pjlobo/SD_Card_Adapter-VCU128/README.md

# SD_Card_Adapter-VCU128

KiCad project of a daughter card for Xilinx UltraScale+ VCU128 FPGA Evaluationn Kit adding a SD card socket and a JTAG header
