pjlobo/SD_Card_Adapter-VCU128/SD_Card_Adapter-VCU128_BOM.xlsx

Manufacturer Part Number | Description | Reference Designator | Quantity | Manufacturer | Supplier Part Number | Supplier name
0603X7R104JT1AT | Multilayer Ceramic Capacitors MLCC- SMD/SMT 25V 0.1uF 0603 X7R 5% Tol | C1, C2, C3, C4, C5 | 5 | ATC / KYOCERA AVX | 581-0603X7R104JT1AT | Mouser
ASP-184330-01 | SEARAY FMC+ Connector, 560 contacts | J1 | 1 | Samtec Inc. | 200-ASP-184330-01 | Mouser
87834-1011 | HDR SHROUDED 10P | J2 | 1 | Molex | 538-87834-1011 | Mouser
GSD090012SEU | SD CARD CONNECTOR 9 POS, SMT | J3 | 1 | Amphenol Commercial Products | 523-GSD090012SEU | Mouser
LG Q396-PS-35-0-20-R18 | SMD LED GREEN | LED1, LED2 | 2 | ams OSRAM | 720-LGQ396A3964 | Mouser
CSL1901VW1 | SMD LED RED | LED3 | 1 | ROHM Semiconductor | 755-CSL1901VW1 | Mouser
SI1012R-T1-GE3 | MOSFET 20V 0.6A 175mW 700mohm @ 4.5V SC-75A-3 package | Q1 | 1 | Vishay Semiconductors | 781-SI1012R-T1-GE3 | Mouser
CR0603-FX-5112ELF | Thick Film Resistors - SMD 51.1K ohm 1% 0603 (1608 metric) | R1, R2, R3, R4, R5, R6, R7, R8, R9, R10, R11, R12, R19, R20, R21, R22, R23, R30 | 18 | Bourns | 652-CR0603FX-5112ELF | Mouser
CR0603-FX-4701ELF | Thick Film Resistors - SMD 4.7K ohm 1% 0603 (1608 metric) | R13, R14, R24, R25, R26, R27, R28 | 7 | Bourns | 652-CR0603FX-4701ELF | Mouser
CR0603-FX-2610ELF | Thick Film Resistors - SMD 261 ohm 1% 0603 (1608 metric) | R16 | 1 | Bourns | 652-CR0603FX-2610ELF | Mouser
CR0603-FX-1620ELF | Thick Film Resistors - SMD 162 ohm 1% 0603 (1608 metric) | R17, R18 | 2 | Bourns | 652-CR0603FX-1620ELF | Mouser
CR0603-FX-1002ELF | Thick Film Resistors - SMD 10K ohm 1% 0603 (1608 metric) | R29 | 1 | Bourns | 652-CR0603FX-1002ELF | Mouser
JS202011CQN | Slide Swidth DPDT THRU HOLE .3A | S1 | 1 | C&K | 611-JS202011CQN | Mouser
B3FS-1000P | SPST Tactile Switch SMD 6x6x3.1mm | S2 | 1 | Omron | 653-B3FS-1000P | Mouser
TXB0108DQSR | 8B Bidir Voltage-Level Translator | U2,U1 | 2 | Texas Instruments | 595-TXB0108DQSR | Mouser
