pjlobo/SD_Card_Adapter-VCU128/3dmodels/B3FS-1000P.stp

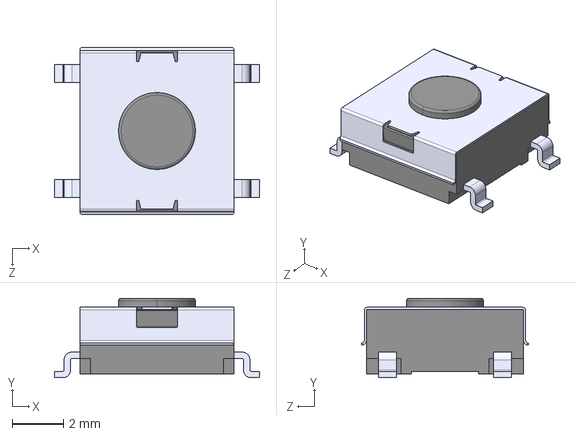
[picture p1: CAD file, 2023-05-25]
3dmodels/B3FS-1000P.stp
8.00 x 3.10 x 6.50 mm
