pjlobo/SD_Card_Adapter-VCU128/3dmodels/LG_Q396-PS-35-0-20-R18.stp

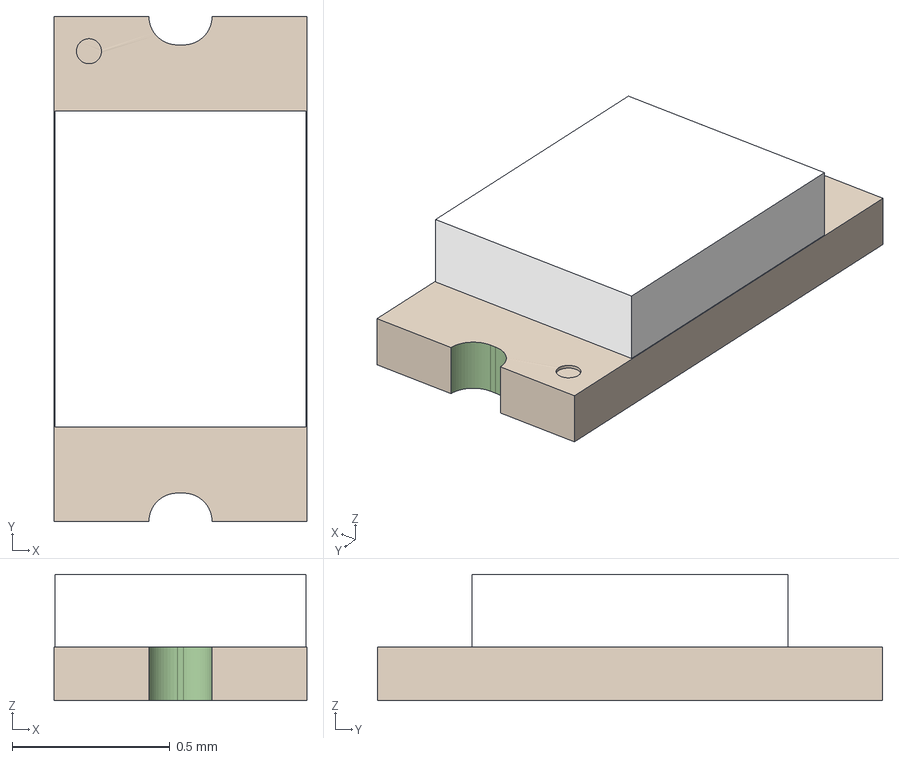
[picture p2: CAD file, 2023-05-25]
3dmodels/LG_Q396-PS-35-0-20-R18.stp
0.8 x 1.60 x 0.4 mm
