pjlobo/SD_Card_Adapter-VCU128/3dmodels/CSL1901VW1.stp

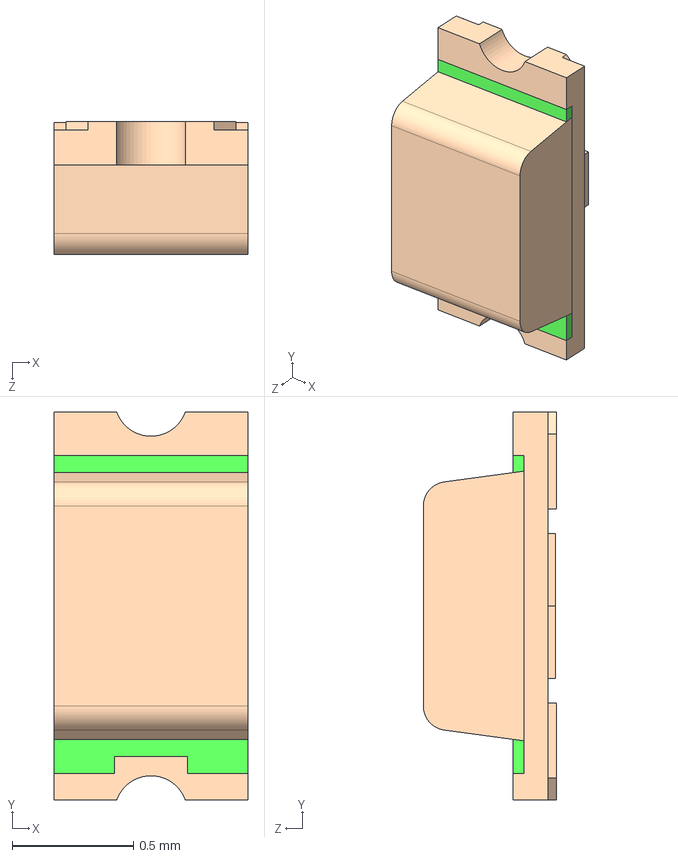
[picture p3: CAD file, 2023-05-25]
3dmodels/CSL1901VW1.stp
0.8 x 1.60 x 0.55 mm
CSL19_2
CSL19_3
CSL19_4
CSL19
CSL19_5
