pjlobo/SD_Card_Adapter-VCU128/3dmodels/SI1012R-T1-GE3.stp

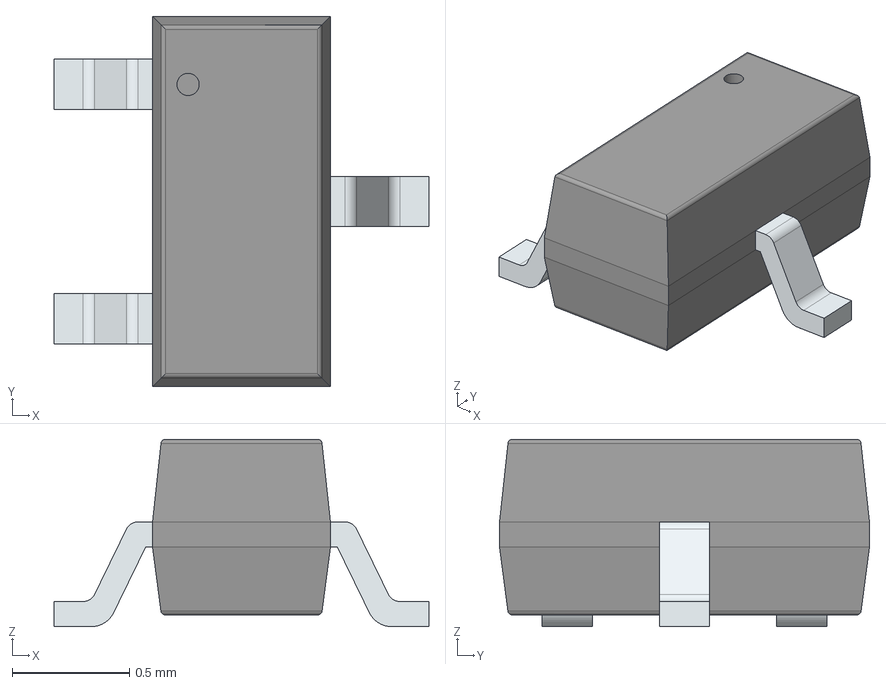
[picture p4: CAD file, 2023-05-25]
3dmodels/SI1012R-T1-GE3.stp
1.60 x 1.58 x 0.8 mm
PinsArrayL
FilletPinR
