pjlobo/SD_Card_Adapter-VCU128/3dmodels/87834-1011.stp

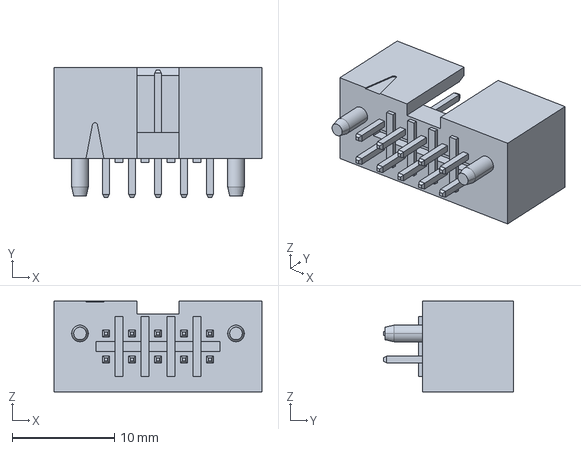
[picture p5: CAD file, 2023-05-25]
3dmodels/87834-1011.stp
20.3 x 12.7 x 8.89 mm
