pjlobo/SD_Card_Adapter-VCU128/3dmodels/GSD090012SEU.stp

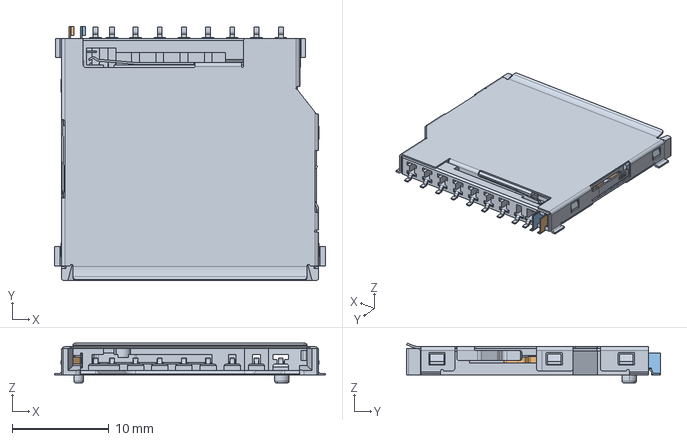
[picture p6: CAD file, 2023-05-25]
3dmodels/GSD090012SEU.stp
28.0 x 26.2 x 4.13 mm
