pjlobo/SD_Card_Adapter-VCU128/3dmodels/JS202011CQN.stp

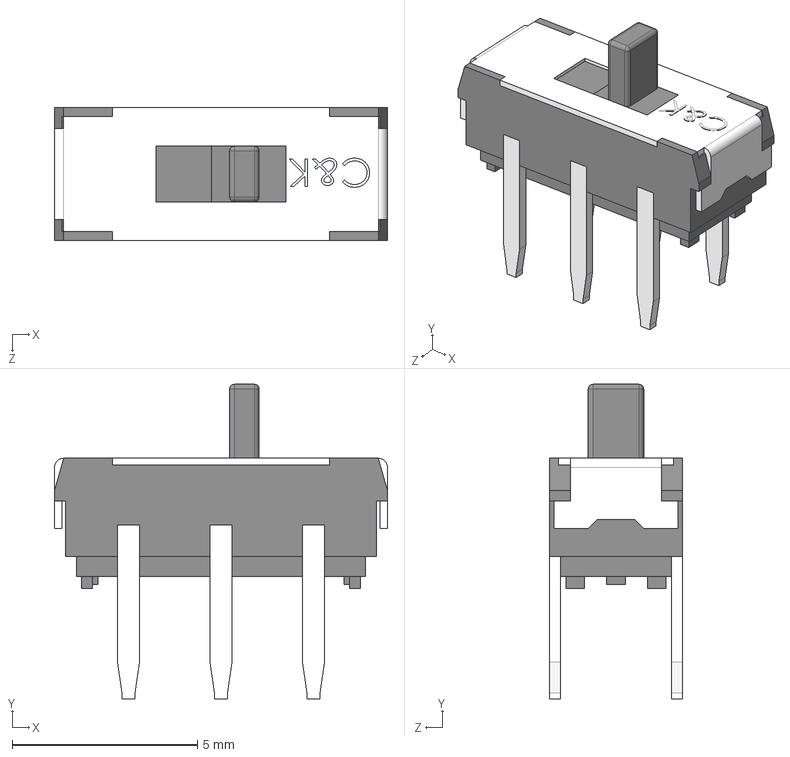
[picture p7: CAD file, 2023-05-25]
3dmodels/JS202011CQN.stp
9.00 x 8.50 x 3.60 mm
