pjlobo/SD_Card_Adapter-VCU128/(list of files, cad)

Other CAD files:
3dmodels/ASP-184330-01.step
