pjlobo/SD_Card_Adapter-VCU128/SD_Card_Adapter-VCU128.kicad_pcb

## KiCad design SD_Card_Adapter-VCU128.kicad_pcb (2023-06-15)

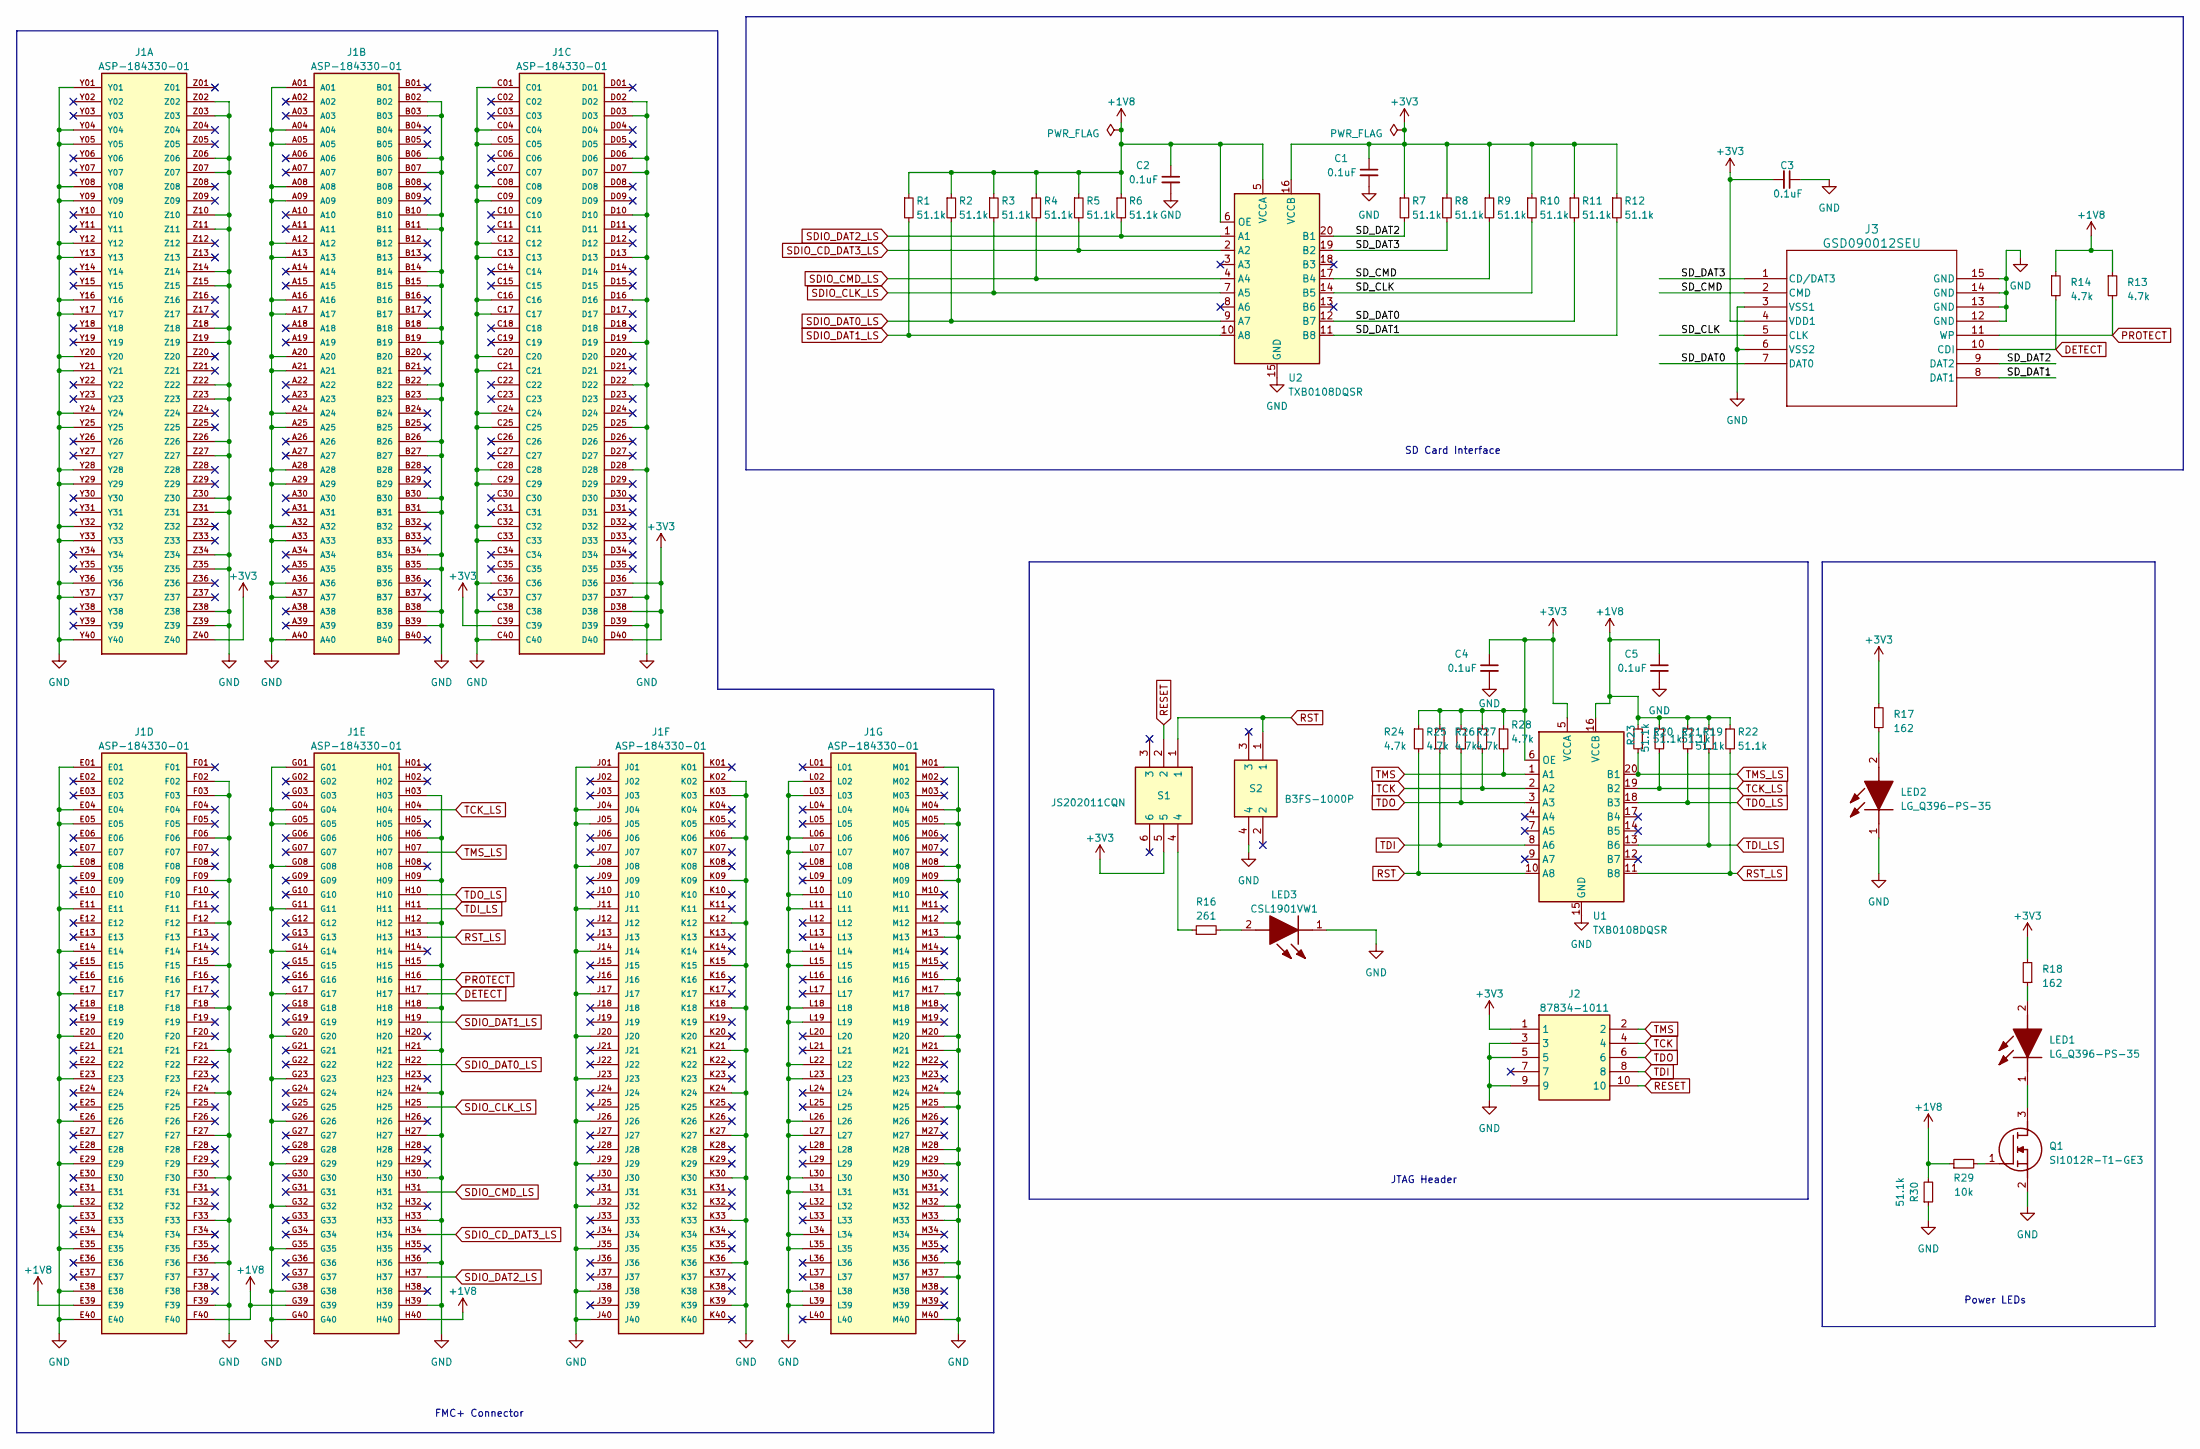
[picture p8: schematic SD_Card_Adapter-VCU128.kicad_sch, FMC+ Daughter Card: SD Card and JTAG Header]

Parts:
C1, C2, C3, C4, C5: 0.1uF; C_0603_1608Metric_Pad1.08x0.95mm_HandSolder
J1: ASP-184330-01; SAMTEC_ASP-184330-01; PARTREV C
J2: 87834-1011; 878341011; Mouser Part Number 538-87834-1011
J3: GSD090012SEU; GSD090012SEU_AMP
LED1, LED2: LG_Q396-PS-35; LEDC1608X40N; Manufacturer_Part_Number LG Q396-PS-35-0-20-R18
LED3: CSL1901VW1; LEDC1608X65N; Mouser Part Number 755-CSL1901VW1
Q1: SI1012R-T1-GE3; SOT50P160X80-3N; Mouser Part Number 781-SI1012R-T1-GE3
R1, R2, R3, R4, R5, R6, R7, R8, R9, R10, R11, R12, R19, R20, R21, R22, R23, R30: 51.1k; R_0603_1608Metric_Pad0.98x0.95mm_HandSolder
R13, R14, R24, R25, R26, R27, R28: 4.7k; R_0603_1608Metric_Pad0.98x0.95mm_HandSolder
R16: 261; R_0603_1608Metric_Pad0.98x0.95mm_HandSolder
R17, R18: 162; R_0603_1608Metric_Pad0.98x0.95mm_HandSolder
R29: 10k; R_0603_1608Metric_Pad0.98x0.95mm_HandSolder
S1: JS202011CQN; Mouser Part Number 611-JS202011CQN
S2: B3FS-1000P; Mouser Part Number 653-B3FS-1000P
U1, U2: TXB0108DQSR; USON-20_2x4mm_P0.4mm

Connections:
+1V8: C2.1, C5.1, J1.E39, J1.F40, J1.G39, J1.H40, R1.1, R2.1, R3.1, R4.1, R5.1, R6.1, R13.1, R14.1, R19.1, R20.1, R21.1, R22.1, R23.1, R29.1, R30.2, U1.16 (VCCB), U2.5 (VCCA), U2.6 (OE)
+3V3: C1.1, C3.2, C4.1, J1.C39, J1.D36, J1.D38, J1.D40, J1.Z40, J2.1, J3.4 (VDD1), R7.1, R8.1, R9.1, R10.1, R11.1, R12.1, R17.1, R18.2, R24.1, R25.1, R26.1, R27.1, R28.1, S1.5, U1.5 (VCCA), U1.6 (OE), U2.16 (VCCB)
/SD_CLK: J3.5 (CLK), R10.2, U2.14 (B5)
/SD_CMD: J3.2 (CMD), R9.2, U2.17 (B4)
/SD_DAT0: J3.7 (DAT0), R11.2, U2.12 (B7)
/SD_DAT1: J3.8 (DAT1), R12.2, U2.11 (B8)
/SD_DAT2: J3.9 (DAT2), R7.2, U2.20 (B1)
/SD_DAT3: J3.1 (CD/DAT3), R8.2, U2.19 (B2)
DETECT: J1.H17, J3.10 (CDI), R14.2
GND: C1.2, C2.2, C3.1, C4.2, C5.2, J1.A01, J1.A04, J1.A05, J1.A08, J1.A09, J1.A12, J1.A13, J1.A16, J1.A17, J1.A20, J1.A21, J1.A24, J1.A25, J1.A28, J1.A29, J1.A32, J1.A33, J1.A36, J1.A37, J1.A40, J1.B02, J1.B03, J1.B06, J1.B07, J1.B10, J1.B11, J1.B14, J1.B15, J1.B18, J1.B19, J1.B22, J1.B23, J1.B26, J1.B27, J1.B30, J1.B31, J1.B34, J1.B35, J1.B38, J1.B39, J1.C01, J1.C04, J1.C05, J1.C08, J1.C09, J1.C12, J1.C13, J1.C16, J1.C17, J1.C20, J1.C21, J1.C24, J1.C25, J1.C28, J1.C29, J1.C32, J1.C33, J1.C36, J1.C38, J1.C40, J1.D02, J1.D03, J1.D06, J1.D07, J1.D10, J1.D13, J1.D16, J1.D19, J1.D22, J1.D25, J1.D28, J1.D37, J1.D39, J1.E01, J1.E04, J1.E05, J1.E08, J1.E11, J1.E14, J1.E17, J1.E20, J1.E23, J1.E26, J1.E29, J1.E32, J1.E35, J1.E38, J1.E40, J1.F02, J1.F03, J1.F06, J1.F09, J1.F12, J1.F15, J1.F18, J1.F21, J1.F24, J1.F27, J1.F30, J1.F33, J1.F36, J1.F39, J1.G01, J1.G04, J1.G05, J1.G08, J1.G11, J1.G14, J1.G17, J1.G20, J1.G23, J1.G26, J1.G29, J1.G32, J1.G35, J1.G38, J1.G40, J1.H03, J1.H06, J1.H09, J1.H12, J1.H15, J1.H18, J1.H21, J1.H24, J1.H27, J1.H30, J1.H33, J1.H36, J1.H39, J1.J01, J1.J04, J1.J05, J1.J08, J1.J11, J1.J14, J1.J17, J1.J20, J1.J23, J1.J26, J1.J29, J1.J32, J1.J35, J1.J38, J1.J40, J1.K02, J1.K03, J1.K06, J1.K09, J1.K12, J1.K15, J1.K18, J1.K21, J1.K24, J1.K27, J1.K30, J1.K33, J1.K36, J1.K39, J1.L02, J1.L03, J1.L06, J1.L07, J1.L10, J1.L11, J1.L14, J1.L15, J1.L18, J1.L19, J1.L22, J1.L23, J1.L26, J1.L27, J1.L30, J1.L31, J1.L34, J1.L35, J1.L38, J1.L39, J1.M01, J1.M04, J1.M05, J1.M08, J1.M09, J1.M12, J1.M13, J1.M16, J1.M17, J1.M20, J1.M21, J1.M24, J1.M25, J1.M28, J1.M29, J1.M32, J1.M33, J1.M36, J1.M37, J1.M40, J1.Y01, J1.Y04, J1.Y05, J1.Y08, J1.Y09, J1.Y12, J1.Y13, J1.Y16, J1.Y17, J1.Y20, J1.Y21, J1.Y24, J1.Y25, J1.Y28, J1.Y29, J1.Y32, J1.Y33, J1.Y36, J1.Y37, J1.Y40, J1.Z02, J1.Z03, J1.Z06, J1.Z07, J1.Z10, J1.Z11, J1.Z14, J1.Z15, J1.Z18, J1.Z19, J1.Z22, J1.Z23, J1.Z26, J1.Z27, J1.Z30, J1.Z31, J1.Z34, J1.Z35, J1.Z38, J1.Z39, J2.3, J2.5, J2.9, J3.3 (VSS1), J3.6 (VSS2), J3.12 (GND), J3.13 (GND), J3.14 (GND), J3.15 (GND), LED2.1 (K), LED3.1 (K), Q1.2 (S), R30.1, S2.4, U1.15 (GND), U2.15 (GND)
unnamed: LED1.2 (A), R18.1
unnamed: LED1.1 (K), Q1.3 (D)
unnamed: LED2.2 (A), R17.2
unnamed: LED3.2 (A), R16.2
unnamed: Q1.1 (G), R29.2
unnamed: R16.1, S1.4
PROTECT: J1.H16, J3.11 (WP), R13.2
RESET: J2.10, S1.2
RST: R24.2, S1.1, S2.1, U1.10 (A8)
RST_LS: J1.H13, R22.2, U1.11 (B8)
SDIO_CD_DAT3_LS: J1.H34, R5.2, U2.2 (A2)
SDIO_CLK_LS: J1.H25, R3.2, U2.7 (A5)
SDIO_CMD_LS: J1.H31, R4.2, U2.4 (A4)
SDIO_DAT0_LS: J1.H22, R2.2, U2.9 (A7)
SDIO_DAT1_LS: J1.H19, R1.2, U2.10 (A8)
SDIO_DAT2_LS: J1.H37, R6.2, U2.1 (A1)
TCK: J2.4, R27.2, U1.2 (A2)
TCK_LS: J1.H04, R20.2, U1.19 (B2)
TDI: J2.8, R25.2, U1.8 (A6)
TDI_LS: J1.H11, R19.2, U1.13 (B6)
TDO: J2.6, R26.2, U1.3 (A3)
TDO_LS: J1.H10, R21.2, U1.18 (B3)
TMS: J2.2, R28.2, U1.1 (A1)
TMS_LS: J1.H07, R23.2, U1.20 (B1)

Notes on the sheet:
JTAG Header
SD Card Interface
Power LEDs
FMC+ Connector

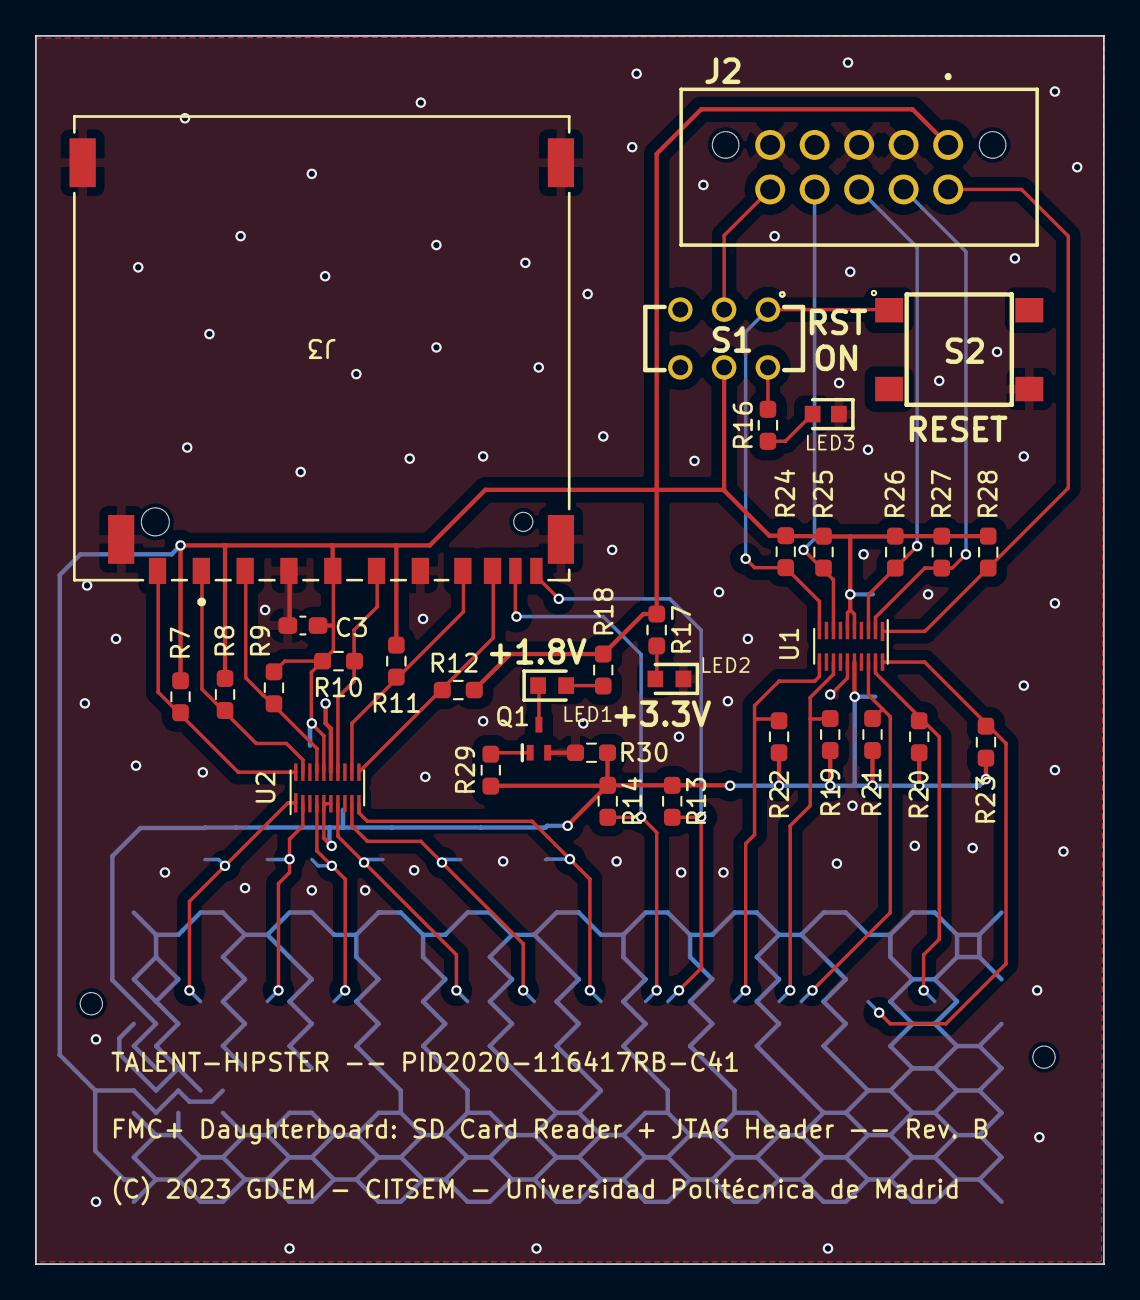
[picture p9: board SD_Card_Adapter-VCU128.kicad_pcb from above]

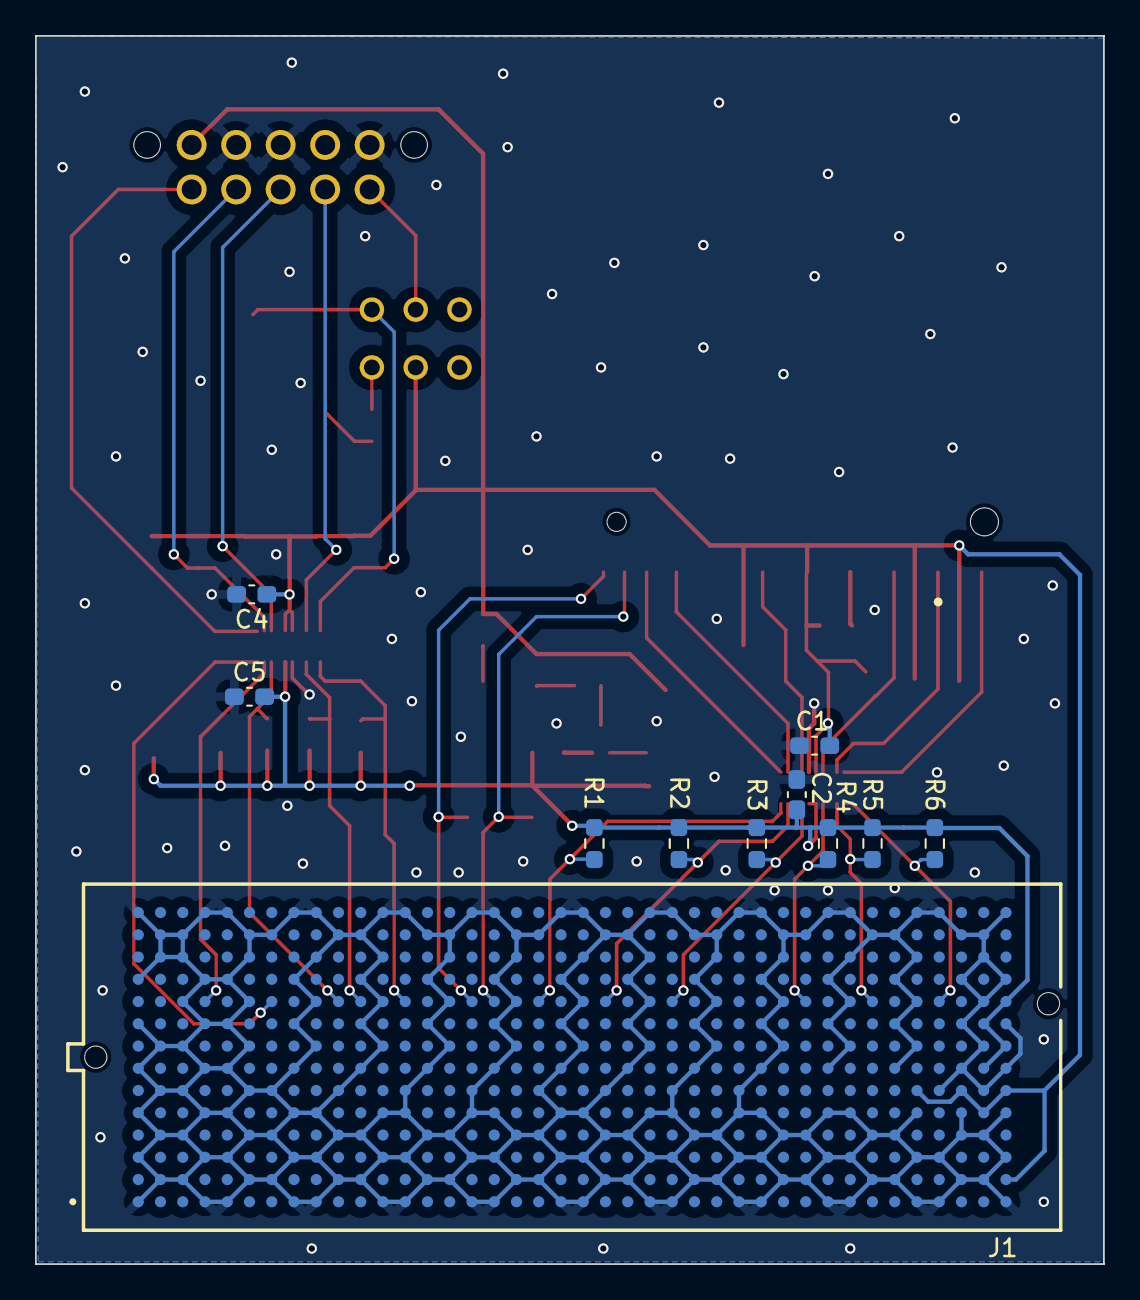
[picture p10: board SD_Card_Adapter-VCU128.kicad_pcb from below]

Board: 2 copper layers, 61.0 x 70.1 mm, 45 parts (11 on the bottom side), 34 nets.
