pjlobo/SD_Card_Adapter-VCU128/(commit log)

2023-06-08 Update PCB date and version, migrate FMC+ connector's 3D model to git-lfs
    [SD_Card_Adapter-VCU128.kicad_pcb]
2023-06-15 Revision B.
    All signals have been moved to row H of FMC+ connector J1
    because the ones in row M are connected to FPGA pins that
    are dedicated to high speed transceivers.
    [SD_Card_Adapter-VCU128.kicad_pcb, SD_Card_Adapter-VCU128.kicad_sch]
