pjlobo/SD_Card_Adapter-VCU128/(notices)

Notices in the files:
SD_Card_Adapter-VCU128.kicad_pcb:
(C) 2023 GDEM - CITSEM - Universidad Politécnica de Madrid
